TinyChipHub/BitaxeGT/BitaxeGT.kicad_pcb

## KiCad design BitaxeGT.kicad_pcb (2025-09-27)

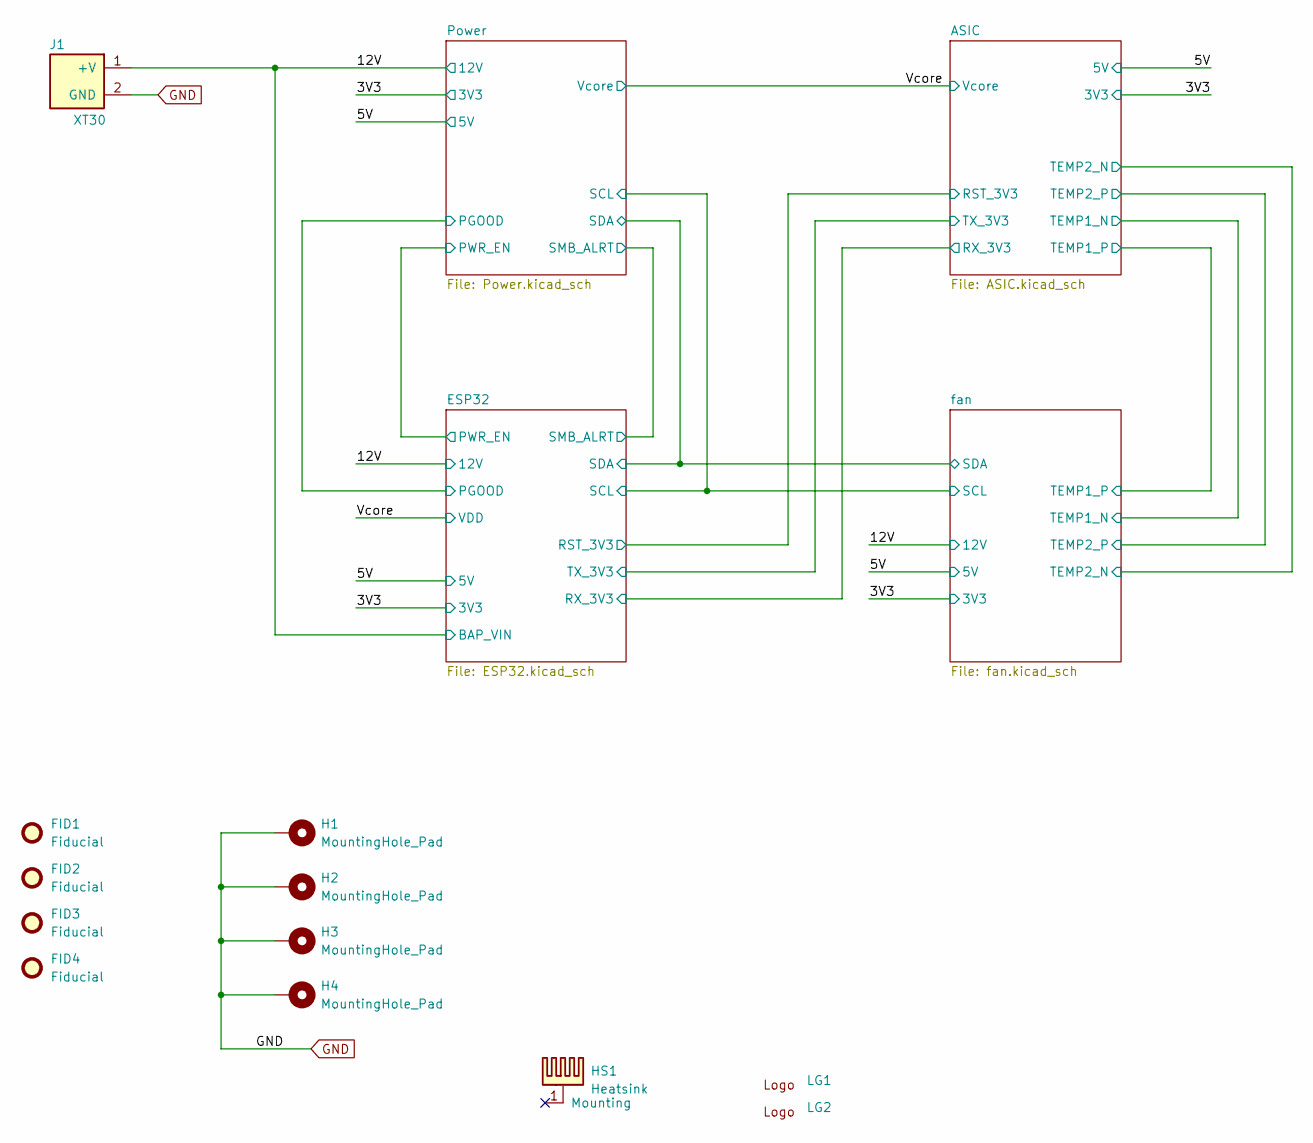
[picture p1: schematic BitaxeGT.kicad_sch, bitaxeGamma Turbo]

Parts:
FID1, FID2, FID3, FID4: Fiducial; Fiducial_1mm_Mask2mm
H1, H2, H3, H4: MountingHole_Pad; MountingHole_3.2mm_M3_Pad_Via
HS1: Heatsink; Heatsink-BitaxeGT
J1: XT30; XT30PW-M; PARTNO XT30PW-M; LCSC C431092
LG1: TCH-Logo
LG2: TCH-Logo-Mask

Connections:
/12V: J1.1 (+V); also elsewhere on the board
GND: H1.1, H2.1, H3.1, H4.1, J1.2 (GND); also elsewhere on the board

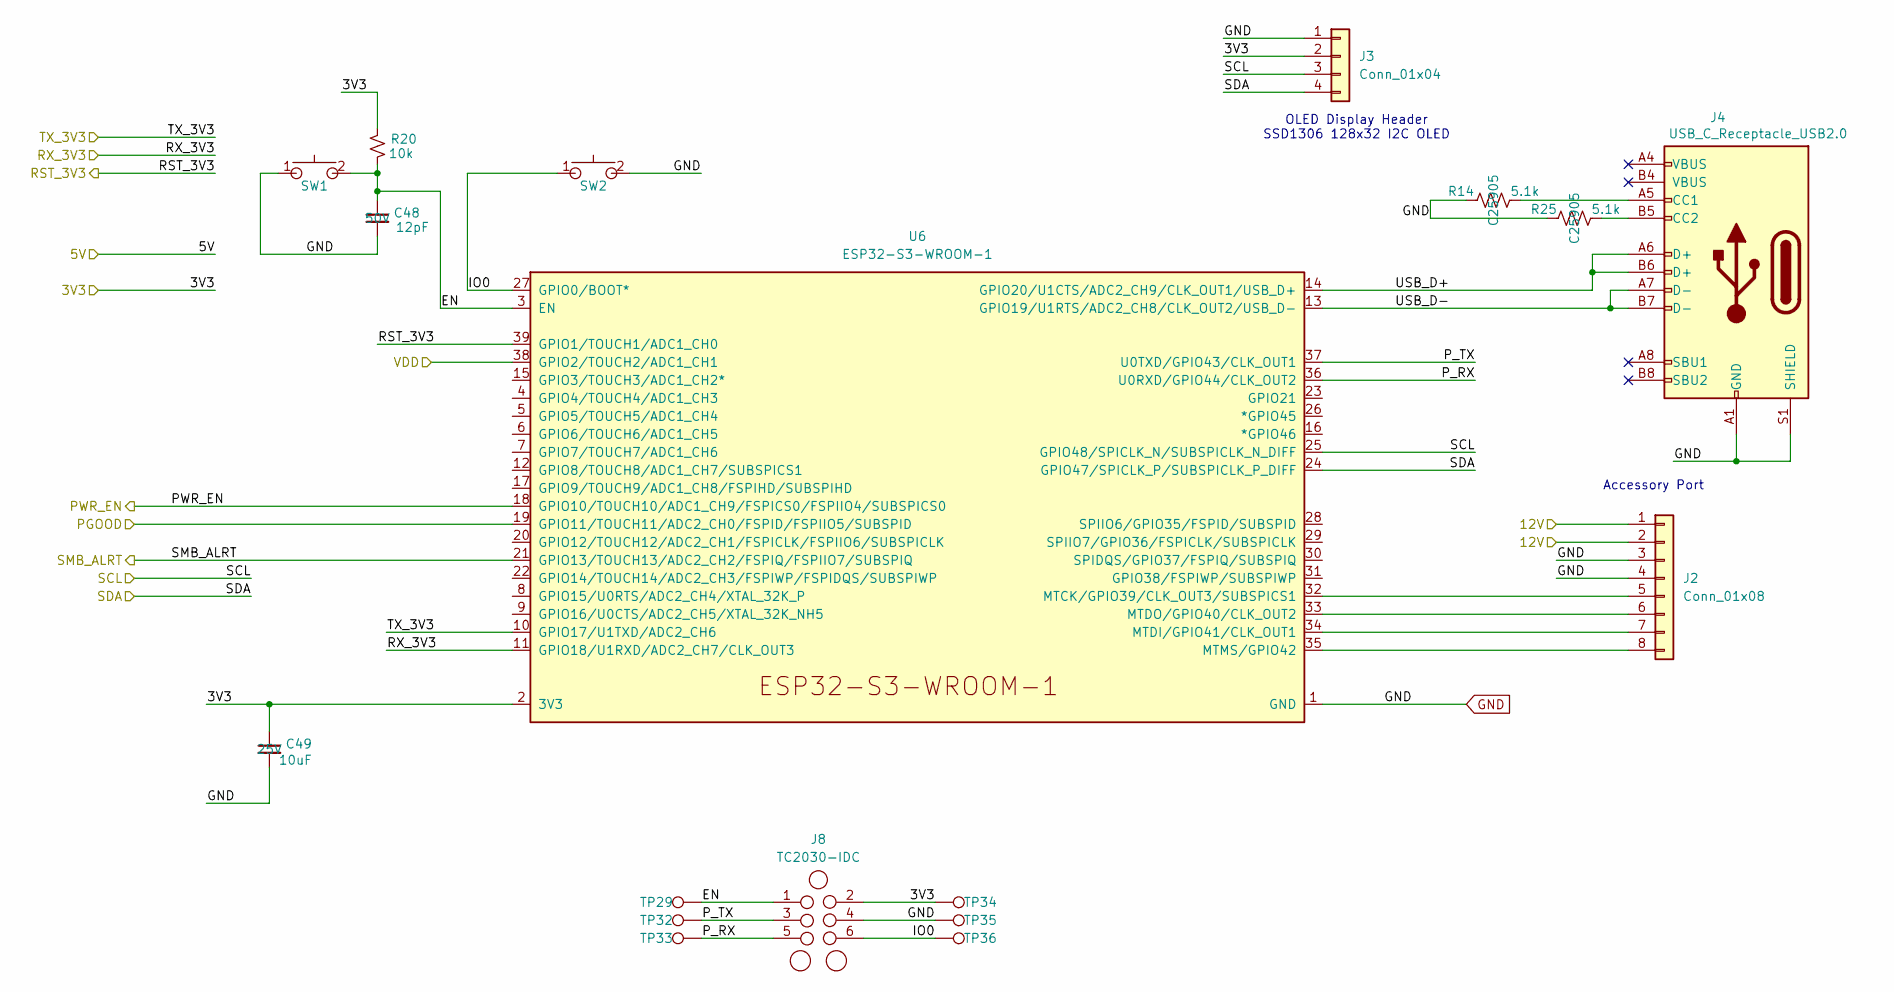
[picture p2: schematic ESP32.kicad_sch, bitaxeGamma Turbo]

Parts:
C48: 12pF; C_0402_1005Metric; Voltage 50V; PARTNO CC0402JRNPO9BN120; LCSC C106201
C49: 10uF; C_0603_1608Metric; Voltage 25V; PARTNO GRM188R61E106KA73D; LCSC C344022
J2: Conn_01x08; FPC-SMD_P0.50-8P_FGS-XJ-H2.0; PARTNO FFC2B35-08-T; LCSC C262657
J3: Conn_01x04; PinHeader_1x04_P2.54mm_Vertical_shifted
J4: USB_C_Receptacle_USB2.0; USB_C_Receptacle_GCT_USB4105-xx-A; PARTNO USB4105-GF-A; LCSC C2982555
J8: TC2030-IDC; Tag-Connect_TC2030-IDC-NL_2x03_P1.27mm_Vertical
R14, R25: 5.1k; R_0402_1005Metric; PARTNO RMCF0402JT5K10; LCSC C25905
R20: 10k; R_0402_1005Metric; PARTNO RC0402JR-0710KL; LCSC C60489
SW1, SW2: SWITCH-SPST; SW_TL3330AF130QG_EWI; PARTNO TL3330AF130QG; LCSC C2886885
TP29, TP32, TP33, TP34, TP35, TP36: TestPoint; TestPoint_Pad_D1.5mm
U6: ESP32-S3-WROOM-1; PARTNO ESP32-S3-WROOM-1-N16R8; LCSC C2913202

Connections:
/3V3: C49.1, J3.2, J8.2, R20.2, TP34.1, U6.2 (3V3); also elsewhere on the board
/12V: J2.1, J2.2; also elsewhere on the board
/ASIC/RST_3V3: U6.39 (GPIO1/TOUCH1/ADC1_CH0); also elsewhere on the board
/ASIC/RX_3V3: U6.11 (GPIO18/U1RXD/ADC2_CH7/CLK_OUT3); also elsewhere on the board
/ASIC/TX_3V3: U6.10 (GPIO17/U1TXD/ADC2_CH6); also elsewhere on the board
/ESP32/EN: C48.1, J8.1, R20.1, SW1.2, TP29.1, U6.3 (EN)
/ESP32/IO0: J8.6, SW2.1, TP36.1, U6.27 (GPIO0/BOOT*)
/ESP32/PWR_EN: U6.18 (GPIO10/TOUCH10/ADC1_CH9/FSPICS0/FSPIIO4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)
/ESP32/P_RX: J8.5, TP33.1, U6.36 (U0RXD/GPIO44/CLK_OUT2)
/ESP32/P_TX: J8.3, TP32.1, U6.37 (U0TXD/GPIO43/CLK_OUT1)
/ESP32/SCL: J3.3, U6.25 (GPIO48/SPICLK_N/SUBSPICLK_N_DIFF); also elsewhere on the board
/ESP32/SDA: J3.4, U6.24 (GPIO47/SPICLK_P/SUBSPICLK_P_DIFF); also elsewhere on the board
/ESP32/SMB_ALRT: U6.21 (GPIO13/TOUCH13/ADC2_CH2/FSPIQ/FSPIIO7/S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); also elsewhere on the board
/ESP32/USB_D+: J4.A6 (D+), J4.B6 (D+), U6.14 (GPIO20/U1CTS/ADC2_CH9/CLK_OUT1/USB_D+)
/ESP32/USB_D-: J4.A7 (D-), J4.B7 (D-), U6.13 (GPIO19/U1RTS/ADC2_CH8/CLK_OUT2/USB_D-)
/Power/PGOOD: U6.19 (GPIO11/TOUCH11/ADC2_CH0/FSPID/FSPIIO5/S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); also elsewhere on the board
/Vcore: U6.38 (GPIO2/TOUCH2/ADC1_CH1); also elsewhere on the board
GND: C48.2, C49.2, J2.3, J2.4, J3.1, J4.A1 (GND), J4.B1 (GND), J4.S1 (SHIELD), J8.4, R14.1, R25.1, SW1.1, SW2.2, TP35.1, U6.1 (GND), U6.40 (GND), U6.41 (GND); also elsewhere on the board
unnamed: J2.5, U6.32 (MTCK/GPIO39/CLK_OUT3/SUBSPICS1)
unnamed: J2.6, U6.33 (MTDO/GPIO40/CLK_OUT2)
unnamed: J2.7, U6.34 (MTDI/GPIO41/CLK_OUT1)
unnamed: J2.8, U6.35 (MTMS/GPIO42)
unnamed: J4.A5 (CC1), R14.2
unnamed: J4.B5 (CC2), R25.2

Notes on the sheet:
OLED Display Header SSD1306 128x32 I2C OLED
Accessory Port

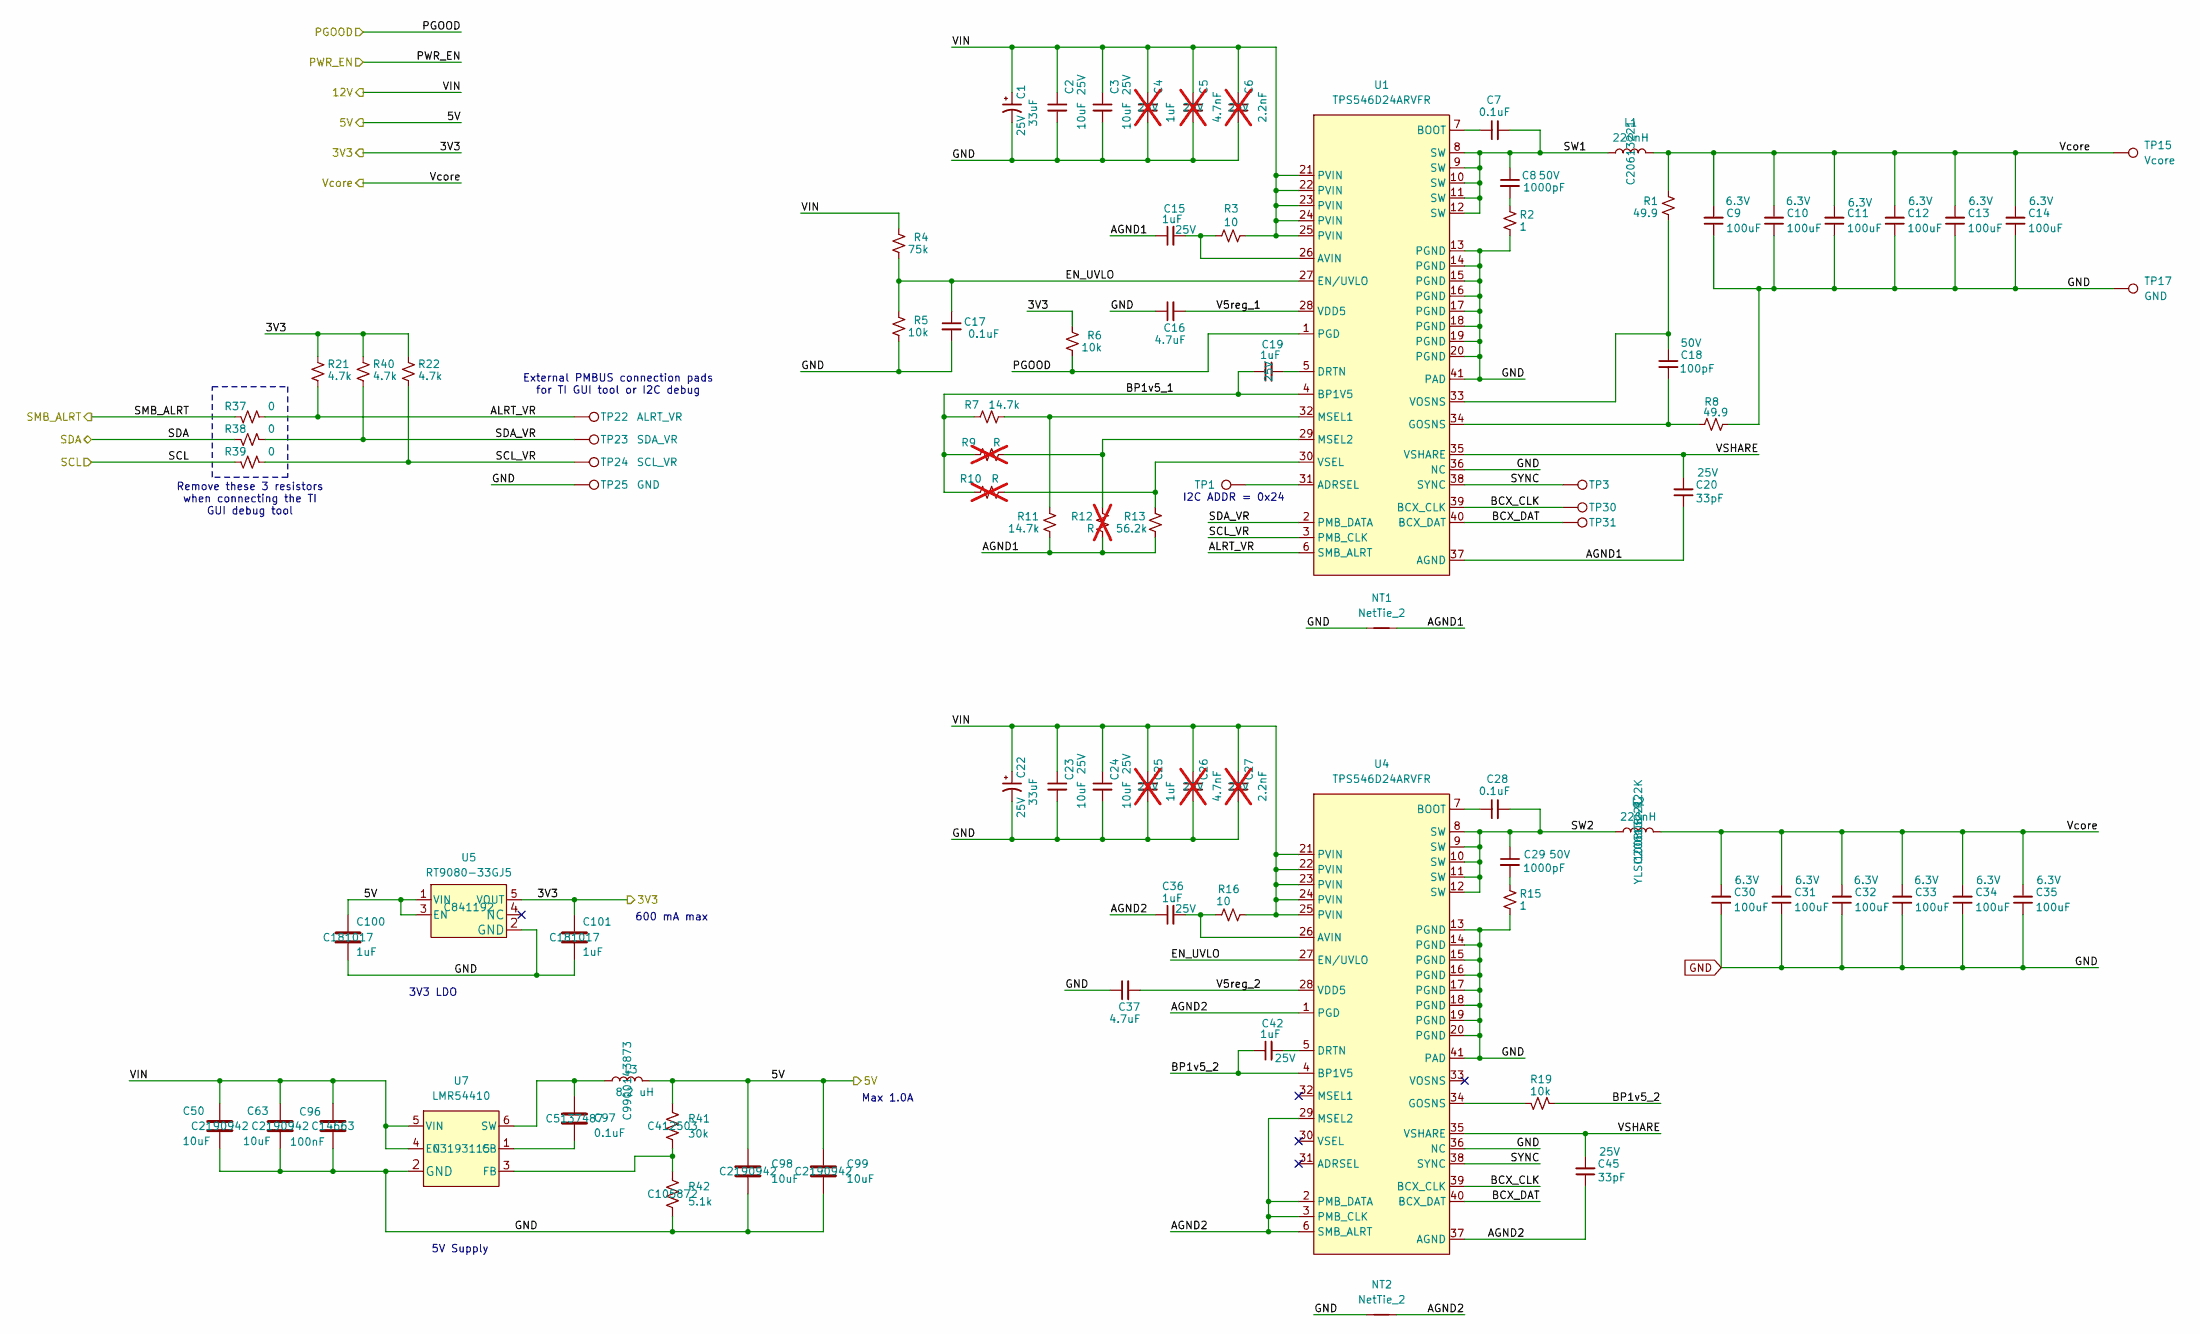
[picture p3: schematic Power.kicad_sch, bitaxeGamma Turbo]

Parts:
C1, C22: 33uF; CP_EIA-7343-31_Kemet-D; Voltage 25V; PARTNO T495D336K025ATE300; LCSC C122327
C2, C3, C23, C24: 10uF; C_0603_1608Metric; Voltage 25V; PARTNO GRM188R61E106KA73D; LCSC C344022
C4, C25: 1uF; C_0402_1005Metric; Voltage 25V; PARTNO TMK107B7105KA-T; not fitted
C5, C26: 4.7nF; C_0402_1005Metric; Voltage 25V; PARTNO GRM155R71E472KA01D; not fitted
C6, C27: 2.2nF; C_0402_1005Metric; Voltage 25V; PARTNO 490-8257-1-ND; not fitted
C7, C17, C28, C97: 0.1uF; C_0402_1005Metric; PARTNO KGM05AR71C104KH; LCSC C5137487
C8, C29: 1000pF; C_0805_2012Metric; Voltage 50V; PARTNO CC0805KRX7R9BB102; LCSC C46653
C9, C10, C11, C12, C13, C14, C30, C31, C32, C33, C34, C35: 100uF; C_1206_3216Metric; Voltage 6.3V; PARTNO CL31A107MQHNNNE; LCSC C15008
C15, C19, C36, C42: 1uF; C_0402_1005Metric; Voltage 25V; PARTNO TMK107B7105KA-T; LCSC C77009
C16, C37: 4.7uF; C_0402_1005Metric; PARTNO GRM155R61A475MEAAD; LCSC C23733
C18: 100pF; C_0402_1005Metric; Voltage 50V; PARTNO CC0402JRNPO9BN101; LCSC C277520
C20, C45: 33pF; C_0402_1005Metric; Voltage 25V; PARTNO KGM05ACG1E330JH; LCSC C526997
C50, C63, C98, C99: 10uF; C_0805_2012Metric; PARTNO GRM21BR61H106ME43L; LCSC C2190942
C96: 100nF; C_0603_1608Metric; PARTNO KGM15BR71H104KT; LCSC C14663
C100, C101: 1uF; C_0402_1005Metric; PARTNO EMK105BJ105MV-F; LCSC C181017
L1, L2: 220nH; SLC1175-271MEC_COC; PARTNO YLSI100808-R22K; LCSC C20613221
L3: 8.2 uH; 74438357082; PARTNO 78438357082; LCSC C9900143873
NT1, NT2: NetTie_2; NetTie-2_SMD_Pad0.2mmx1mm
R1, R8: 49.9; R_0402_1005Metric; PARTNO RC0402FR-0749R9L; LCSC C87044
R2, R15: 1; R_0805_2012Metric; PARTNO ESR10EZPJ1R0; LCSC C253344
R3, R16: 10; R_0402_1005Metric; PARTNO RC0402FR-0710RL; LCSC C138066
R4: 75k; R_0402_1005Metric; PARTNO RC0402FR-0775KL; LCSC C137935
R5, R6, R19: 10k; R_0402_1005Metric; PARTNO RC0402JR-0710KL; LCSC C60489
R7, R11: 14.7k; R_0402_1005Metric; PARTNO AC0402FR-0714K7L; LCSC C138055
R9, R10, R12: R; R_0402_1005Metric; not fitted
R13: 56.2k; R_0402_1005Metric; PARTNO RC0402FR-0756K2L; LCSC C183355
R21, R22, R40: 4.7k; R_0402_1005Metric; PARTNO RC0402JR-074K7L; LCSC C105870
R37, R38, R39: 0; R_0402_1005Metric; PARTNO RC0402JR-070RL; LCSC C60485
R41: 30k; R_0402_1005Metric; PARTNO AC0402FR-0730KL; LCSC C412503
R42: 5.1k; R_0402_1005Metric; PARTNO RC0402FR-075K1L; LCSC C105872
TP1: TestPoint; TestPoint_Pad_D1.0mm
TP3, TP30: BCX_CLK; TestPoint_Pad_D1.0mm
TP15: Vcore; TestPoint_Pad_D1.5mm
TP17, TP25: GND; TestPoint_Pad_D1.5mm
TP22: ALRT_VR; TestPoint_Pad_D1.5mm
TP23: SDA_VR; TestPoint_Pad_D1.5mm
TP24: SCL_VR; TestPoint_Pad_D1.5mm
TP31: BCX_DAT; TestPoint_Pad_D1.0mm
U1, U4: TPS546D24ARVFR; LQFN40-CLIP; PARTNO TPS546D24ARVFR; LCSC C507280
U5: RT9080-33GJ5; PARTNO RT9080-33GJ5; LCSC C841192
U7: LMR54410; SOT-23-6; PARTNO LMR54410FDBVR; LCSC C3193115

Connections:
/3V3: C101.1, R6.2, R21.1, R22.1, R40.1, U5.5 (VOUT); also elsewhere on the board
/5V: C98.1, C99.1, C100.1, L3.2, R41.1, U5.1 (VIN), U5.3 (EN); also elsewhere on the board
/12V: C1.1, C2.1, C3.1, C4.1, C5.1, C6.1, C22.1, C23.1, C24.1, C25.1, C26.1, C27.1, C50.1, C63.1, C96.2, R3.1, R4.2, R16.1, U1.21 (PVIN), U1.22 (PVIN), U1.23 (PVIN), U1.24 (PVIN), U1.25 (PVIN), U4.21 (PVIN), U4.22 (PVIN), U4.23 (PVIN), U4.24 (PVIN), U4.25 (PVIN), U7.4 (EN), U7.5 (VIN); also elsewhere on the board
/ESP32/SCL: R39.1; also elsewhere on the board
/ESP32/SDA: R38.1; also elsewhere on the board
/ESP32/SMB_ALRT: R37.1; also elsewhere on the board
/Power/AGND1: C15.1, C20.1, NT1.2, R11.2, R12.1, R13.1, U1.37 (AGND)
/Power/AGND2: C36.1, C45.1, NT2.2, U4.1 (PGD), U4.2 (PMB_DATA), U4.3 (PMB_CLK), U4.6 (SMB_ALRT), U4.29 (MSEL2), U4.37 (AGND)
/Power/ALRT_VR: R21.2, R37.2, TP22.1, U1.6 (SMB_ALRT)
/Power/BCX_CLK: TP30.1, U1.39 (BCX_CLK), U4.39 (BCX_CLK)
/Power/BCX_DAT: TP31.1, U1.40 (BCX_DAT), U4.40 (BCX_DAT)
/Power/BP1v5_1: C19.1, R7.2, R9.2, R10.2, U1.4 (BP1V5)
/Power/BP1v5_2: C42.1, R19.1, U4.4 (BP1V5)
/Power/EN_UVLO: C17.1, R4.1, R5.2, U1.27 (EN/UVLO), U4.27 (EN/UVLO)
/Power/PGOOD: R6.1, U1.1 (PGD); also elsewhere on the board
/Power/SCL_VR: R22.2, R39.2, TP24.1, U1.3 (PMB_CLK)
/Power/SDA_VR: R38.2, R40.2, TP23.1, U1.2 (PMB_DATA)
/Power/SW1: C7.2, C8.1, L1.1, U1.8 (SW), U1.9 (SW), U1.10 (SW), U1.11 (SW), U1.12 (SW)
/Power/SW2: C28.2, C29.1, L2.1, U4.8 (SW), U4.9 (SW), U4.10 (SW), U4.11 (SW), U4.12 (SW)
/Power/SYNC: TP3.1, U1.38 (SYNC), U4.38 (SYNC)
/Power/V5reg_1: C16.2, U1.28 (VDD5)
/Power/V5reg_2: C37.2, U4.28 (VDD5)
/Power/VSHARE: C20.2, C45.2, U1.35 (VSHARE), U4.35 (VSHARE)
/Vcore: C9.2, C10.2, C11.2, C12.2, C13.2, C14.2, C30.2, C31.2, C32.2, C33.2, C34.2, C35.2, L1.2, L2.2, R1.1, TP15.1; also elsewhere on the board
GND: C1.2, C2.2, C3.2, C4.2, C5.2, C6.2, C9.1, C10.1, C11.1, C12.1, C13.1, C14.1, C16.1, C17.2, C22.2, C23.2, C24.2, C25.2, C26.2, C27.2, C30.1, C31.1, C32.1, C33.1, C34.1, C35.1, C37.1, C50.2, C63.2, C96.1, C98.2, C99.2, C100.2, C101.2, NT1.1, NT2.1, R2.2, R5.1, R8.2, R15.2, R42.2, TP17.1, TP25.1, U1.13 (PGND), U1.14 (PGND), U1.15 (PGND), U1.16 (PGND), U1.17 (PGND), U1.18 (PGND), U1.19 (PGND), U1.20 (PGND), U1.36 (NC), U1.41 (PAD), U4.13 (PGND), U4.14 (PGND), U4.15 (PGND), U4.16 (PGND), U4.17 (PGND), U4.18 (PGND), U4.19 (PGND), U4.20 (PGND), U4.36 (NC), U4.41 (PAD), U5.2 (GND), U7.2 (GND); also elsewhere on the board
unnamed: C8.2, R2.1
unnamed: C29.2, R15.1
unnamed: TP1.1, U1.31 (ADRSEL)
unnamed: C15.2, R3.2, U1.26 (AVIN)
unnamed: C7.1, U1.7 (BOOT)
unnamed: C19.2, U1.5 (DRTN)
unnamed: C18.2, R8.1, U1.34 (GOSNS)
unnamed: R7.1, R11.1, U1.32 (MSEL1)
unnamed: R9.1, R12.2, U1.29 (MSEL2)
unnamed: C18.1, R1.2, U1.33 (VOSNS)
unnamed: R10.1, R13.2, U1.30 (VSEL)
unnamed: C36.2, R16.2, U4.26 (AVIN)
unnamed: C28.1, U4.7 (BOOT)
unnamed: C42.2, U4.5 (DRTN)
unnamed: R19.2, U4.34 (GOSNS)
unnamed: C97.2, U7.1 (CB)
unnamed: R41.2, R42.1, U7.3 (FB)
unnamed: C97.1, L3.1, U7.6 (SW)

Notes on the sheet:
External PMBUS connection pads for TI GUI tool or I2C debug
Max 1.0A
3V3 LDO
Remove these 3 resistors when connecting the TI GUI debug tool
I2C ADDR = 0x24
600 mA max
5V Supply

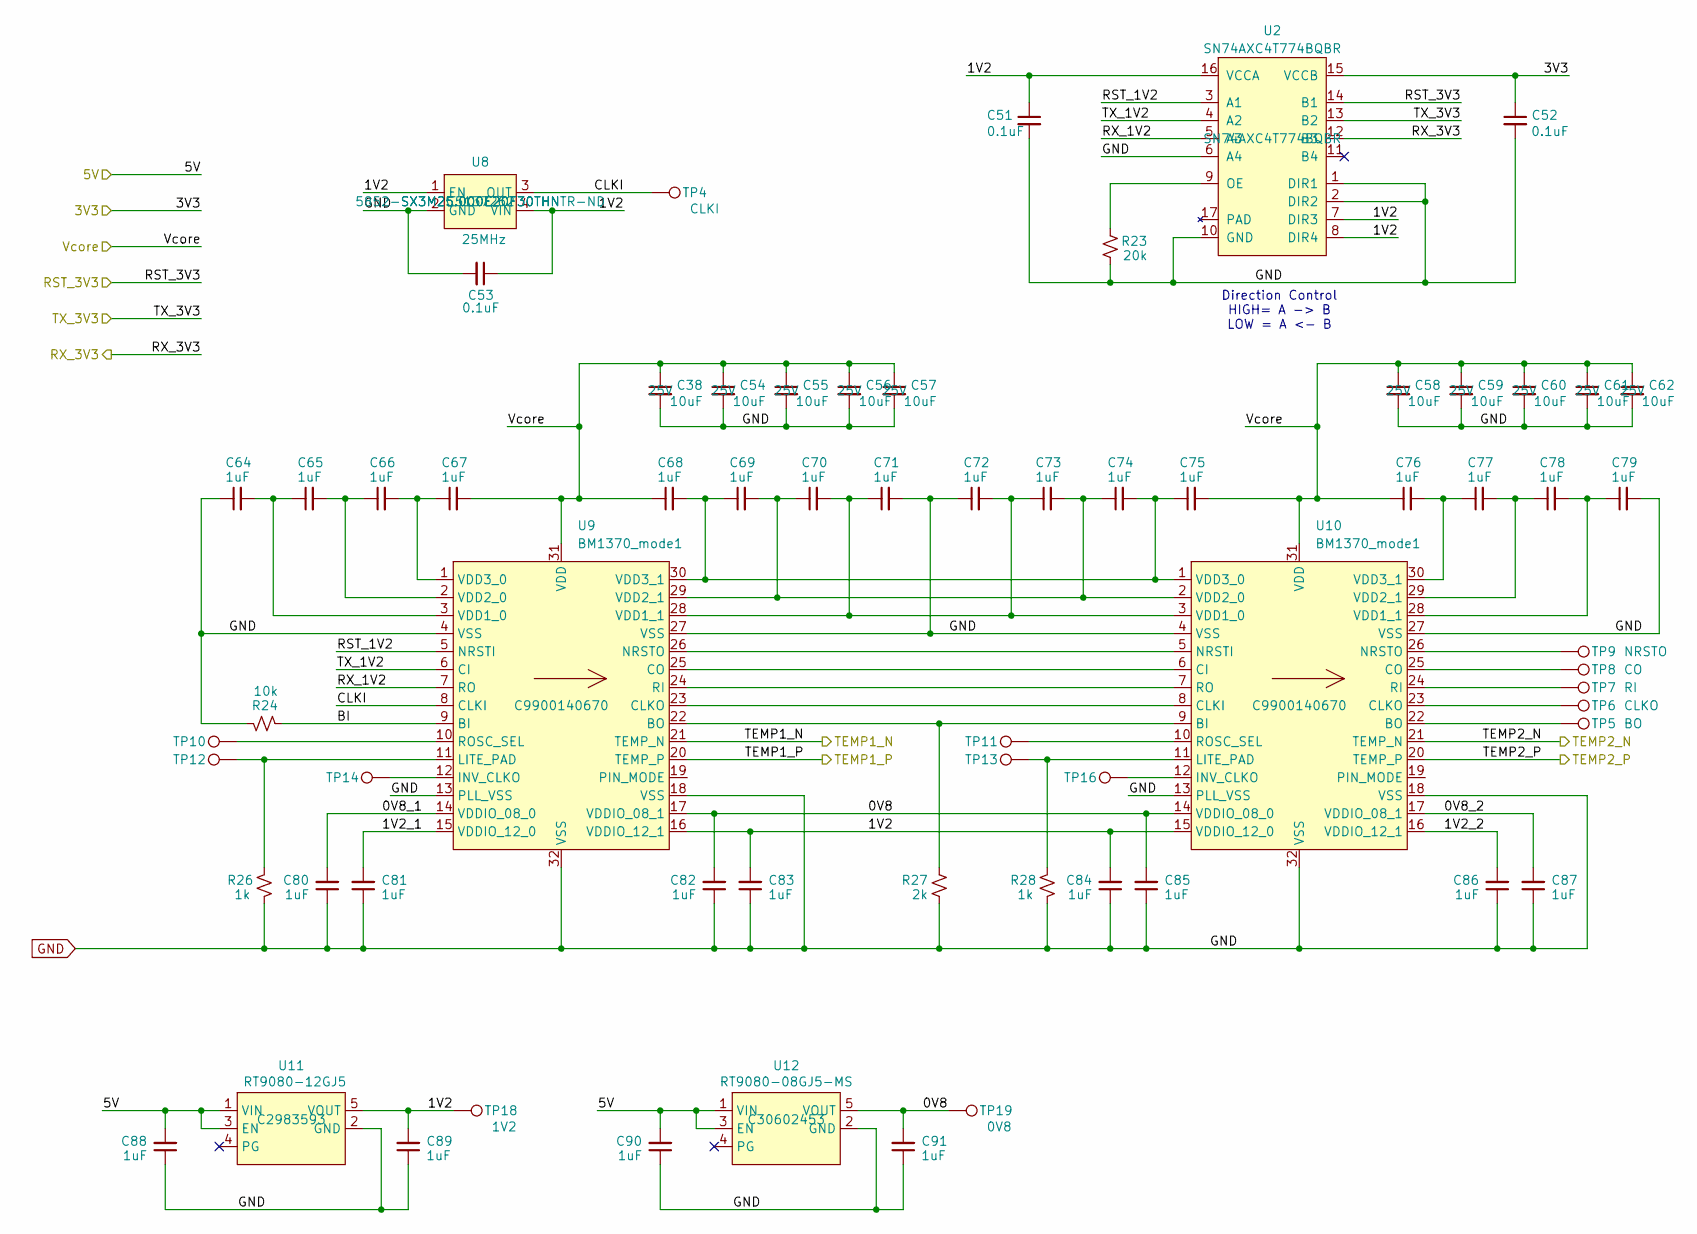
[picture p4: schematic ASIC.kicad_sch, bitaxeGamma Turbo]

Parts:
C38, C54, C55, C56, C57, C58, C59, C60, C61, C62: 10uF; C_0603_1608Metric; Voltage 25V; PARTNO GRM188R61E106KA73D; LCSC C344022
C51, C52, C53: 0.1uF; C_0402_1005Metric; PARTNO KGM05AR71C104KH; LCSC C5137487
C64, C65, C66, C67, C68, C69, C70, C71, C72, C73, C74, C75, C76, C77, C78, C79, C80, C81, C82, C83, C84, C85, C86, C87, C88, C89, C90, C91: 1uF; C_0402_1005Metric; PARTNO EMK105BJ105MV-F; LCSC C181017
R23: 20k; R_0402_1005Metric; PARTNO RC0402FR-0720KL; LCSC C93942
R24: 10k; R_0402_1005Metric; PARTNO RC0402JR-0710KL; LCSC C60489
R26, R28: 1k; R_0402_1005Metric; PARTNO RC0402FR-071KL; LCSC C106235
R27: 2k; R_0402_1005Metric; PARTNO RT0402BRD072KL; LCSC C852711
TP4: CLKI; TestPoint_Pad_D1.0mm
TP5: BO; TestPoint_Pad_D1.0mm
TP6: CLKO; TestPoint_Pad_D1.0mm
TP7: RI; TestPoint_Pad_D1.0mm
TP8: CO; TestPoint_Pad_D1.0mm
TP9: NRSTO; TestPoint_Pad_D1.0mm
TP10, TP11, TP12, TP13, TP14, TP16: TestPoint; TestPoint_Pad_D1.0mm
TP18: 1V2; TestPoint_Pad_D1.5mm
TP19: 0V8; TestPoint_Pad_D1.5mm
U2: SN74AXC4T774BQBR; BQB0016A-MFG; PARTNO SN74AXC4T774BQBR; LCSC C2862903
U8: 25MHz; SMD3225-4P; PARTNO SX3M25.000E20F30THN; LCSC C5137262
U9, U10: BM1370_mode1; BM1370; LCSC C9900140670
U11: RT9080-12GJ5; SOT-23-5; PARTNO MCP1824T-1202E/OT; LCSC C2983593
U12: RT9080-08GJ5-MS; SOT-23-5; PARTNO MCP1824T-0802E/OT; LCSC C30602453

Connections:
/3V3: C52.1, U2.15 (VCCB); also elsewhere on the board
/5V: C88.2, C90.2, U11.1 (VIN), U11.3 (EN), U12.1 (VIN), U12.3 (EN); also elsewhere on the board
/ASIC/0V8: C82.2, C85.2, C91.2, TP19.1, U9.17 (VDDIO_08_1), U10.14 (VDDIO_08_0), U12.5 (VOUT)
/ASIC/0V8_1: C80.2, U9.14 (VDDIO_08_0)
/ASIC/0V8_2: C87.2, U10.17 (VDDIO_08_1)
/ASIC/1V2: C51.1, C53.1, C83.2, C84.2, C89.2, TP18.1, U2.7 (DIR3), U2.8 (DIR4), U2.16 (VCCA), U8.1 (EN), U8.4 (VIN), U9.16 (VDDIO_12_1), U10.15 (VDDIO_12_0), U11.5 (VOUT)
/ASIC/1V2_1: C81.2, U9.15 (VDDIO_12_0)
/ASIC/1V2_2: C86.2, U10.16 (VDDIO_12_1)
/ASIC/BI: R24.2, U9.9 (BI)
/ASIC/CLKI: TP4.1, U8.3 (OUT), U9.8 (CLKI)
/ASIC/RST_1V2: U2.3 (A1), U9.5 (NRSTI)
/ASIC/RST_3V3: U2.14 (B1); also elsewhere on the board
/ASIC/RX_1V2: U2.5 (A3), U9.7 (RO)
/ASIC/RX_3V3: U2.12 (B3); also elsewhere on the board
/ASIC/TEMP1_N: U9.21 (TEMP_N); also elsewhere on the board
/ASIC/TEMP1_P: U9.20 (TEMP_P); also elsewhere on the board
/ASIC/TEMP2_N: U10.21 (TEMP_N); also elsewhere on the board
/ASIC/TEMP2_P: U10.20 (TEMP_P); also elsewhere on the board
/ASIC/TX_1V2: U2.4 (A2), U9.6 (CI)
/ASIC/TX_3V3: U2.13 (B2); also elsewhere on the board
/Vcore: C38.1, C54.1, C55.1, C56.1, C57.1, C58.1, C59.1, C60.1, C61.1, C62.1, C67.2, C68.1, C75.2, C76.1, U9.31 (VDD), U10.31 (VDD); also elsewhere on the board
GND: C38.2, C51.2, C52.2, C53.2, C54.2, C55.2, C56.2, C57.2, C58.2, C59.2, C60.2, C61.2, C62.2, C64.1, C71.2, C72.1, C79.2, C80.1, C81.1, C82.1, C83.1, C84.1, C85.1, C86.1, C87.1, C88.1, C89.1, C90.1, C91.1, R23.1, R24.1, R26.1, R27.1, R28.1, U2.1 (DIR1), U2.2 (DIR2), U2.6 (A4), U2.10 (GND), U8.2 (GND), U9.4 (VSS), U9.13 (PLL_VSS), U9.18 (VSS), U9.27 (VSS), U9.32 (VSS), U10.4 (VSS), U10.13 (PLL_VSS), U10.18 (VSS), U10.27 (VSS), U10.32 (VSS), U11.2 (GND), U12.2 (GND); also elsewhere on the board
unnamed: R23.2, U2.9 (OE)
unnamed: TP14.1, U9.12 (INV_CLKO)
unnamed: R26.2, TP12.1, U9.11 (LITE_PAD)
unnamed: TP10.1, U9.10 (ROSC_SEL)
unnamed: C64.2, C65.1, U9.3 (VDD1_0)
unnamed: C65.2, C66.1, U9.2 (VDD2_0)
unnamed: C66.2, C67.1, U9.1 (VDD3_0)
unnamed: R27.2, U9.22 (BO), U10.9 (BI)
unnamed: TP5.1, U10.22 (BO)
unnamed: U9.25 (CO), U10.6 (CI)
unnamed: U9.23 (CLKO), U10.8 (CLKI)
unnamed: TP6.1, U10.23 (CLKO)
unnamed: TP8.1, U10.25 (CO)
unnamed: TP16.1, U10.12 (INV_CLKO)
unnamed: R28.2, TP13.1, U10.11 (LITE_PAD)
unnamed: U9.26 (NRSTO), U10.5 (NRSTI)
unnamed: TP9.1, U10.26 (NRSTO)
unnamed: TP7.1, U10.24 (RI)
unnamed: U9.24 (RI), U10.7 (RO)
unnamed: TP11.1, U10.10 (ROSC_SEL)
unnamed: C70.2, C71.1, C72.2, C73.1, U9.28 (VDD1_1), U10.3 (VDD1_0)
unnamed: C78.2, C79.1, U10.28 (VDD1_1)
unnamed: C69.2, C70.1, C73.2, C74.1, U9.29 (VDD2_1), U10.2 (VDD2_0)
unnamed: C77.2, C78.1, U10.29 (VDD2_1)
unnamed: C68.2, C69.1, C74.2, C75.1, U9.30 (VDD3_1), U10.1 (VDD3_0)
unnamed: C76.2, C77.1, U10.30 (VDD3_1)

Notes on the sheet:
Direction Control HIGH= A -> B LOW = A <- B

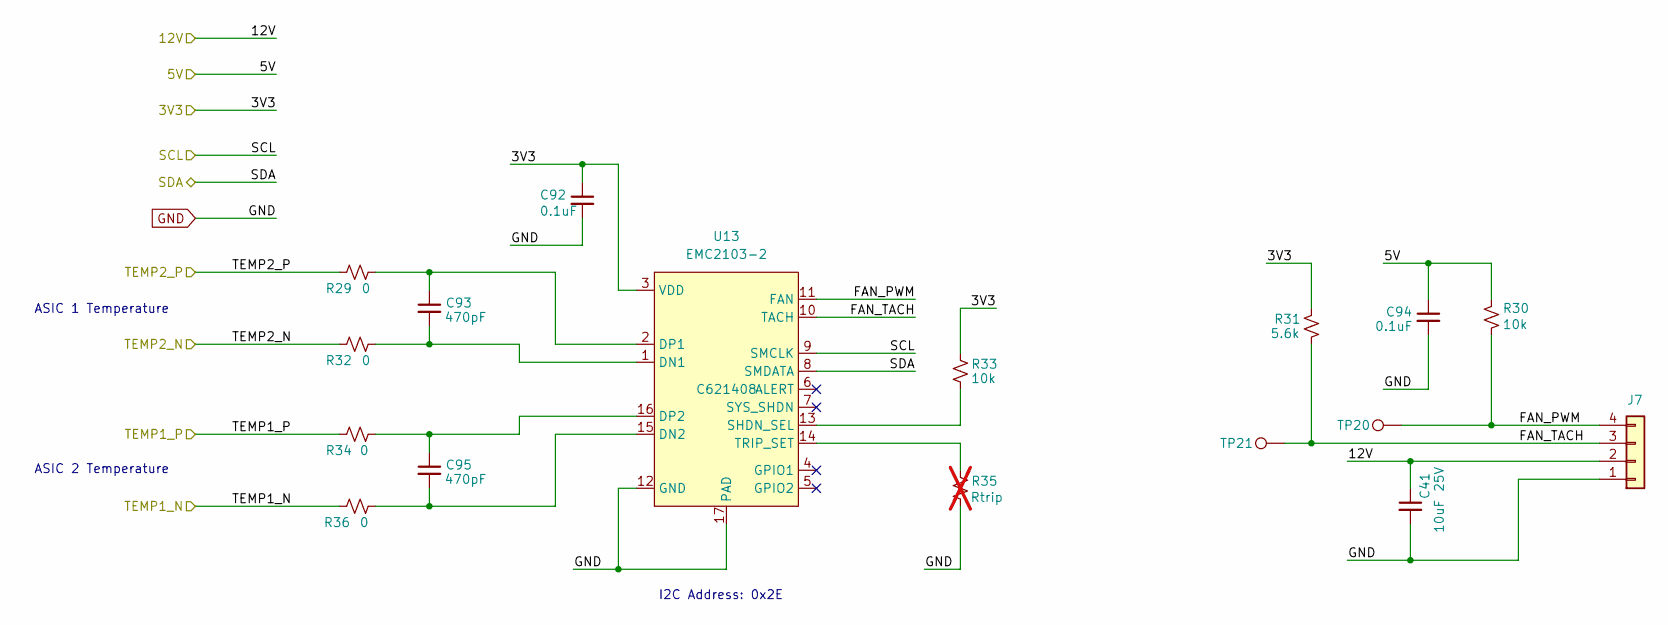
[picture p5: schematic fan.kicad_sch, bitaxeGamma Turbo]

Parts:
C41: 10uF; C_0603_1608Metric; Voltage 25V; PARTNO GRM188R61E106KA73D; LCSC C344022
C92, C94: 0.1uF; C_0402_1005Metric; PARTNO KGM05AR71C104KH; LCSC C5137487
C93, C95: 470pF; C_0402_1005Metric; PARTNO GRM1555C1H471JA01D; LCSC C76971
J7: Conn_01x04; 470531000; PARTNO 0470531000; LCSC C240840
R29, R32, R34, R36: 0; R_0402_1005Metric; PARTNO RC0402JR-070RL; LCSC C60485
R30, R33: 10k; R_0402_1005Metric; PARTNO RC0402JR-0710KL; LCSC C60489
R31: 5.6k; R_0402_1005Metric; PARTNO RC0402FR-075K6L; LCSC C163457
R35: Rtrip; R_0402_1005Metric; not fitted
TP20, TP21: TestPoint; TestPoint_Pad_D1.0mm
U13: EMC2103-2; QFN-16-1EP_4x4mm_P0.65mm_EP2.1x2.1mm; PARTNO EMC2103-4-AP-TR; LCSC C621408

Connections:
/3V3: C92.1, R31.2, R33.2, U13.3 (VDD); also elsewhere on the board
/5V: C94.1, R30.2; also elsewhere on the board
/12V: C41.1, J7.2; also elsewhere on the board
/ASIC/TEMP1_N: R36.2; also elsewhere on the board
/ASIC/TEMP1_P: R34.2; also elsewhere on the board
/ASIC/TEMP2_N: R32.2; also elsewhere on the board
/ASIC/TEMP2_P: R29.2; also elsewhere on the board
/ESP32/SCL: U13.9 (SMCLK); also elsewhere on the board
/ESP32/SDA: U13.8 (SMDATA); also elsewhere on the board
/fan/FAN_PWM: J7.4, R30.1, TP20.1, U13.11 (FAN)
/fan/FAN_TACH: J7.3, R31.1, TP21.1, U13.10 (TACH)
GND: C41.2, C92.2, C94.2, J7.1, R35.1, U13.12 (GND), U13.17 (PAD); also elsewhere on the board
unnamed: C93.2, R32.1, U13.1 (DN1)
unnamed: C95.2, R36.1, U13.15 (DN2)
unnamed: C93.1, R29.1, U13.2 (DP1)
unnamed: C95.1, R34.1, U13.16 (DP2)
unnamed: R33.1, U13.13 (SHDN_SEL)
unnamed: R35.2, U13.14 (TRIP_SET)

Notes on the sheet:
I2C Address: 0x2E
ASIC 2 Temperature
ASIC 1 Temperature

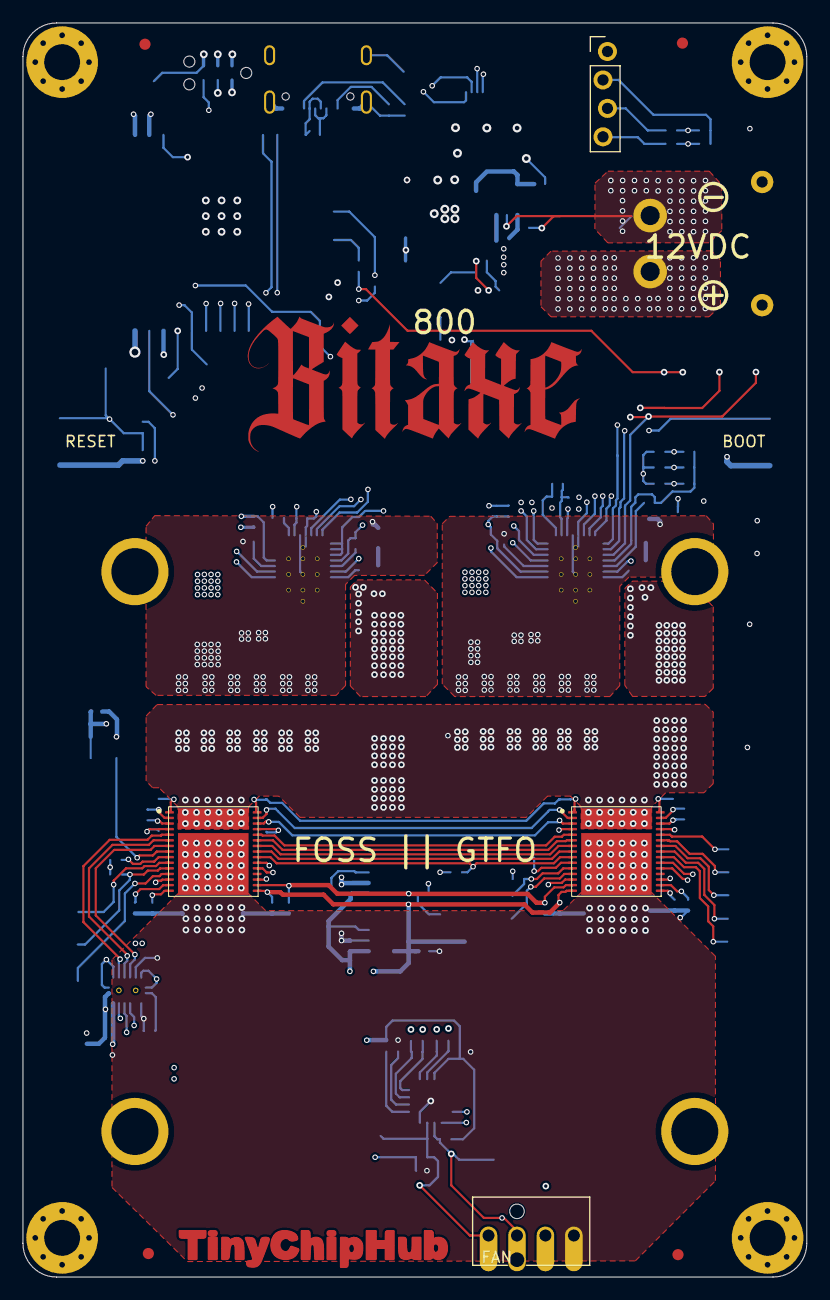
[picture p6: board BitaxeGT.kicad_pcb from above]

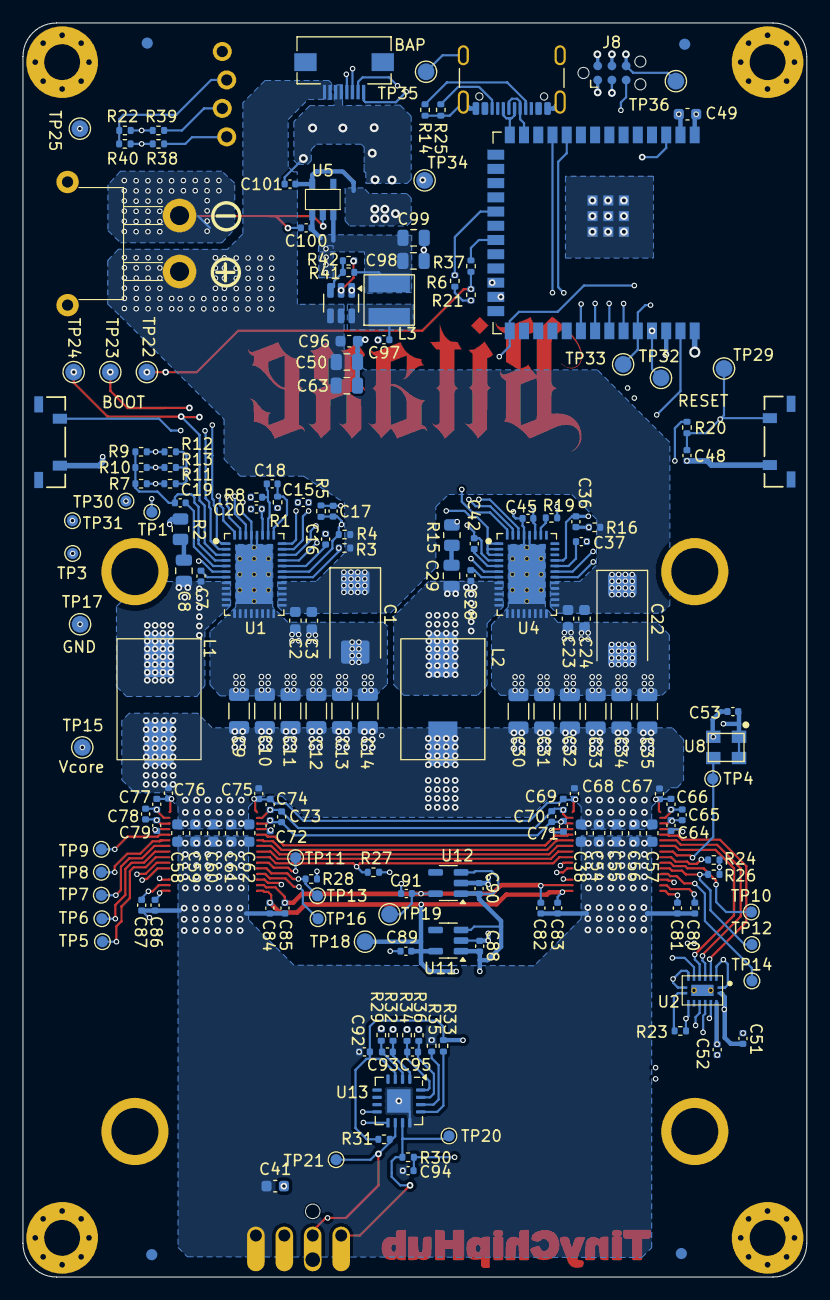
[picture p7: board BitaxeGT.kicad_pcb from below]

Board: 6 copper layers, 70.0 x 112.0 mm, 196 parts (183 on the bottom side), 107 nets.
