TinyChipHub/BitaxeGT/(commit log)

2025-09-13 add TCH logo
    [BitaxeGT.kicad_pcb, BitaxeGT.kicad_sch]
2025-09-13 add LCSC code
    [ASIC.kicad_sch, ESP32.kicad_sch, Power.kicad_sch, fan.kicad_sch]
2025-09-16 Start changing ldo to match our production
    [BitaxeGT.kicad_pcb, Power.kicad_sch]
2025-09-16 final update
    [ASIC.kicad_sch, BitaxeGT BOM.csv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]
2025-09-16 change cap
    [BitaxeGT.kicad_pcb, Power.kicad_sch]
2025-09-27 tune component positions
    [BitaxeGT.kicad_pcb]
